romain327/machine-turing/rapport/rapport.pdf

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

# Table des matières

1 Introduction | 2
2 Reprise de l'existant | 5
3 Conception | 6
3.3.4 | Spécications des fonctions et de leurs signaux de communication . . . . 13
4 Synthèse | 32
5 Remerciements | 33
6 Annexes | 34

# Introduction

1.1 Un peu d'histoire...

En 1928, Le mathématicien allemand David Hilbert énonce le "problème de la décision". Il se demande s'il est possible de trouver une méthode eectivement calculable pour décider si une proposition est démontrable. Pour résoudre ce problème, il faut caractériser ce qu'est un procédé eectivement calculable. C'est alors qu'Alan Turing, alors en thèse à Cambridge, conceptualise une machine universelle et prouve grâce à cette dernière que le problème de l'arrêt est indécidable, ce qui permet de donner une réponse négative au problème d'Hilbert pour l'arithmétique. C'est alors qu'Alan Turing introduit les concepts de programme et programmation.
Ce concept de machine universelle, que nous appellerons désormais Machine de Turing Universelle (MTU) n'est pas réalisable puisqu'il s'agit d'un objet mathématique, dont on va détailler le fonctionnement plus tard. Néanmoins, une Machine de Turing à état ni peut-être construite, et la première vit donc le jour à Bletchley Park pendant la Seconde Guerre Mondiale, où Turing lui-même et une équipe de scientique triés sur le volet par le MI6 ¹
construisirent une Machine de Turing pour casser les codes allemands générés par la machine Enigma. [1]

## 1.2 Fonctionnement d'une MTU

Une MTU se compose de quatre éléments essentiels :
− un ruban de taille innie, divisé en cases.
− une tête de lecture/écriture (qu'on appellera simplement tête de lecture, même si elle permet également d'écrire sur le ruban)
− un état interne
− une table de transition.
Une machine de Turing traite des symboles. L'ensemble des symboles est appelé Alphabet. Le ruban permet d'accueillir des symboles qui seront lus et écrits par la tête de lecture.
La tête de lecture permet de lire et écrire un symbole. Elle peut se déplacer vers la gauche ou la droite.

Une machine de Turing fonctionne donc de la manière suivante :
1. La tête de lecture lit le symbole qu'elle pointe sur le ruban.
2. En fonction de son état et du symbole lu, la tête de lecture écrit un symbole à la place de celui qu'elle a lu précédemment.
1. Services de renseignement britanniques

3. Un déplacement est choisi en fonction de l'état de la tête de lecture et du symbole lu.
4. La tête de lecture change d'état.
5. Le ruban se déplace vers la droite ou vers la gauche selon le déplacement choisi précédemment.
6. Puis on recommence depuis le 1.
On peut donc résumer le fonctionnement comme cela : à chaque "cycle", on choisi un symbole à écrire, un nouvel état pour la tête de lecture, et un déplacement, en fonction d'un symbole lu et de l'état actuel. On peut donc dénir une fonction de transition, qui va se charger de déterminer l'état futur d'une MTU en fonction de ton état courant. L'ensemble des fonctions de transition permettant de traiter un "mot" peut être représenté sous la forme d'une table de transitions ou d'un graphe de transitions.
Un mot traité est dit accepté si une Machine de Turing s'arrête en état nal après l'avoir intégralement traité.
Une MTU possède forcément un nombre ni d'états, et elle a au moins deux états obligatoires : qO l'état initial, et F un ensemble d'états d'acceptation.

Une machine de Turing est donc dénie par :

− Q un ensemble ni d'états.

− q0 un état initial tel que q0 ∈ Q.

− F un ensemble d'états d'acceptation tel que F ⊆ Q.

− Γ un ensemble ni de symboles.

− Σ un ensemble ni de symboles d'entrée tel que Σ ⊆ Γ.

− B un symbole de ruban vide tel que B ∈ Γ \ Σ.
− δ une fonction de transition.

Une fonction de transition se formalise donc comme ceci :

δ(q, Z) → (p, Y, D)

avec q l'état de la tête de lecture, Z le symbole pointé, p le nouvel état, Y le nouveau symbole et D le déplacement. [2]

Exemple d'une table de transition pour une Machine de Turing acceptant le langage L = {a

k
b

k
| k > 0} avec q0 comme état initial (représenté par une →), et q4 comme état d'acceptation (représenté par ∗) :


Le but de ce projet va donc être de concevoir une Machine de Turing électronique fonctionnant tel que déni ci-dessus.

# Reprise de l'existant

Le projet Machine de Turing se base sur un système existant dans le commerce. Le but est de concevoir une machine avec des fonctionnalités se rapprochant de ce modèle existant.[3]
Ce projet avait déjà été donné l'an passé, et nous avons eu accès à l'analyse et la maquette produite par le groupe qui s'en était chargé.
Leur maquette fonctionne, elle se compose de 8 boutons poussoirs, d'un micro-contrôleur PIC24FJ64GA002, et de deux matrices de LEDs SparkFun communiquant en SPI.
Nous avons trouvé que leur travail pouvait être amélioré, et nous avons proposé un cahier des charges ambitieux au client. Le travail d'analyse eectué l'an passé correspondait à peu près à la partie 1 de notre cahier des charges, c'est pourquoi nous avons décidé de rajouter deux autres parties, pour nous rapprocher le plus possible du système modèle.

# Conception

## 3.1 Cahier des charges

Le cahier des charges est composé de trois parties. La partie 1 doit être traitée absolument, les parties 2 et 3 seront traitées si le temps nous le permet.

### 3.1.1 Partie 1

Dans un premier temps, le système conçu doit être capable de :
− exécuter un programme prédéni (codé en dur dans le programme microcontrôleur). − avoir un mode pas à pas pour l'exécution du programme.
− avoir un mode continu pour l'exécution du programme.
− gérer l'achage de l'état du ruban.
− gérer l'achage de la position de la tête de lecture.
− gérer l'achage de la table de transition.

### 3.1.2 Partie 2

Dans un second temps, il faut rajouter :
− la possibilité de sélectionner un programme via un menu.
− le stockage des programmes à sélectionner.
− l'initialisation manuelle du ruban et de la position de la tête de lecture.

### 3.1.3 Partie 3

Enn pour obtenir un système complet, il faut implémenter :
− la programmation directement sur la machine d'une table de transition.
− l'enregistrement de la table de transition programmée dans le support de stockage. − un reset de la programmation de la ligne en cours.
− l'achage d'une description du programme.

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

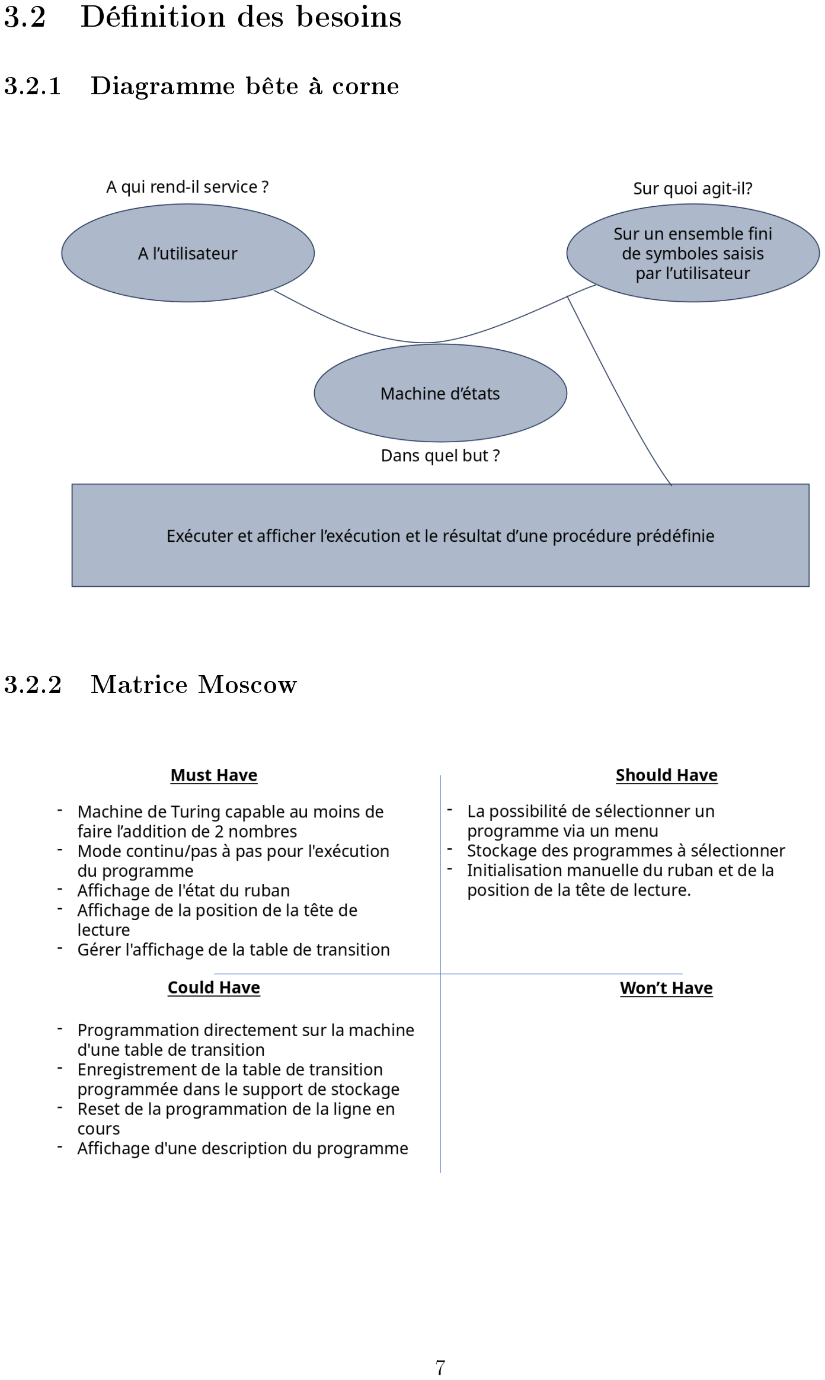
[picture p53: page 8]

## 3.3 Conception Matérielle

Pour concevoir notre système, nous avons décidé de traiter les trois parties en même temps, ce qui nous évite de devoir repasser par une phase de conception et d'adaptation lors de la réalisation des parties 2 et 3.

### 3.3.1 SFN1

Nous avons donc commencé par dessiner un Schéma fonctionnel de premier niveau, pour dénir les diérentes entrées et sorties de notre système :


### 3.3.2 SFnD

On peut désormais rentrer un peu plus dans le détail avec un SF1D :

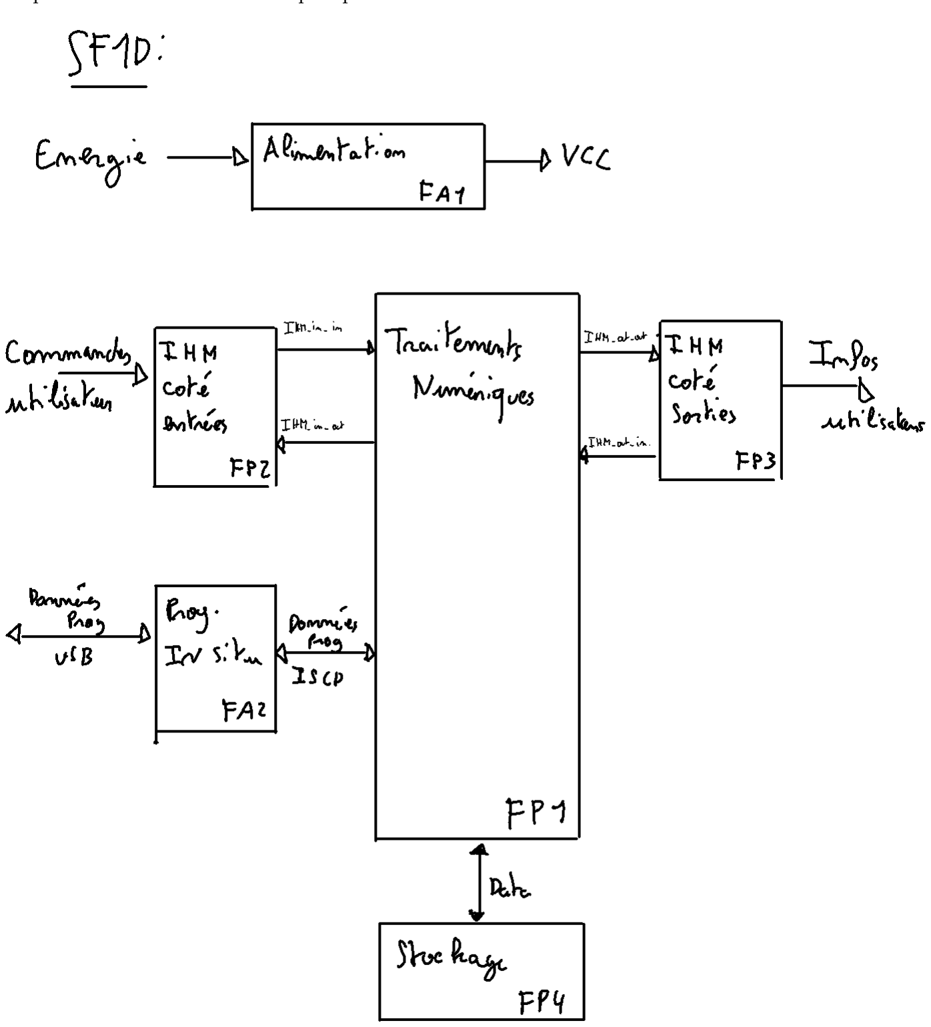
[picture p54: figure]

On voit qu'on a quatre fonctions principales : une qui s'occupe de la gestion des entrées (FP2), une qui gère les sorties (FP3), une fonction de stockage pour stocker les tables de transitions (FP4), et du traitement numérique qui va piloter tout ça (FP1).
On a aussi deux fonctions annexes : la fonction alimentation qui va se charger de fournir le courant nécessaire pour que la machine puisse fonctionner, et la fonction de programmation in-situ qui va faciliter le chargement du code dans la machine et nous éviter d'avoir à sortir le micro-contrôleur (MCU) à chaque fois.

On voit que les fonctions FP2 et FP3 sont encore oues, on va donc les aner en faisant des SF2D pour qu'on se rende compte de leur fonctionnement :

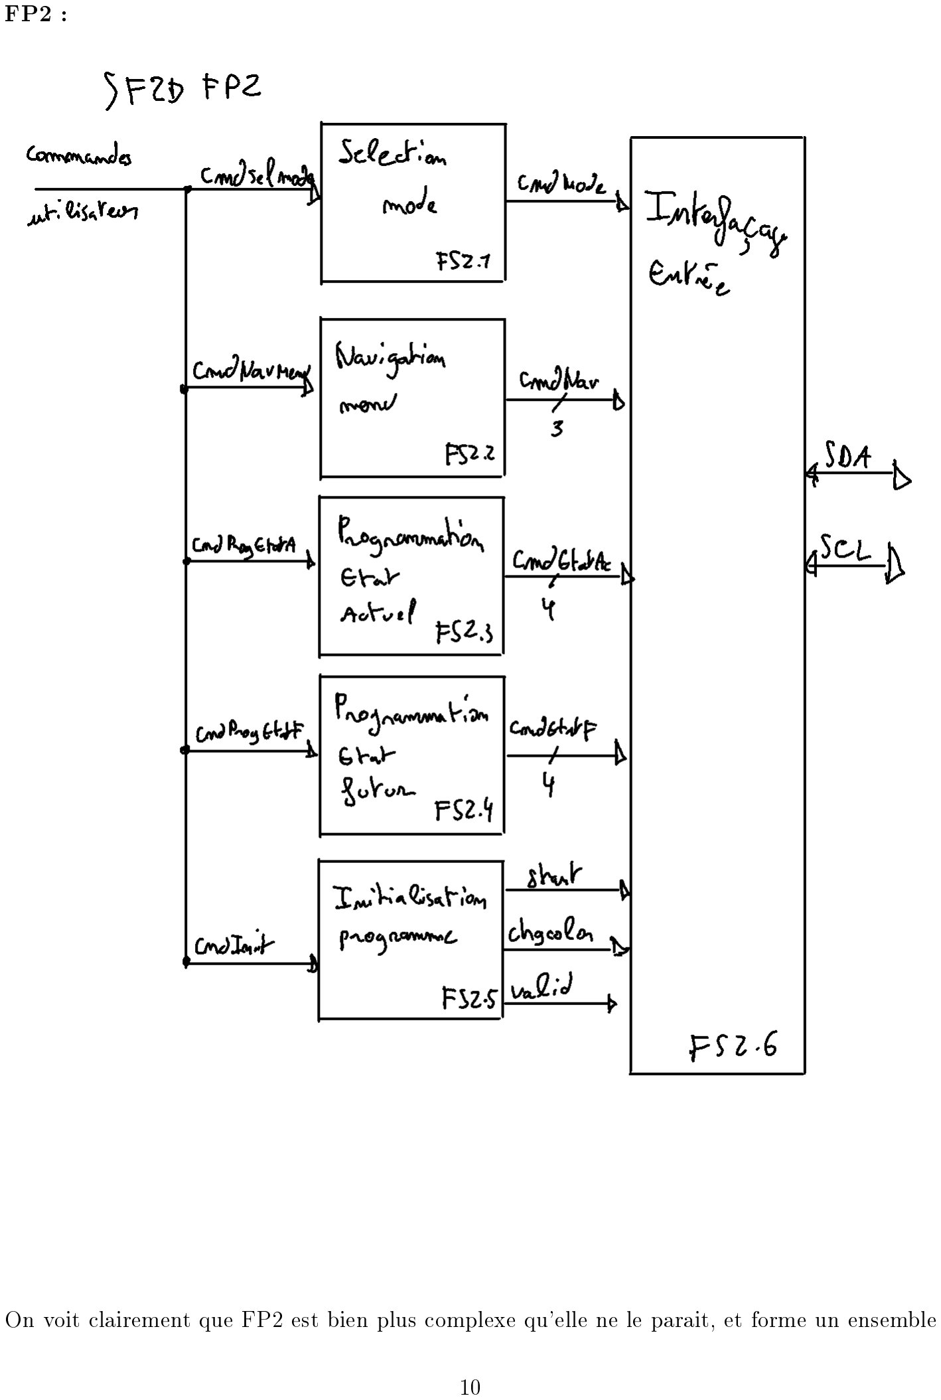
[picture p55: page 11]

FP2 :

On voit clairement que FP2 est bien plus complexe qu'elle ne le parait, et forme un ensemble de fonctions plus spéciques qui vont permettre à l'utilisateur d'interagir physiquement avec la machine, dans le but de la congurer, programmer, etc.


FP3 :

De la même manière que pour FP2, FP3 est en réalité un ensemble de fonctions plus spéciques qui vont chacune avoir un rôle bien précis dans le retour des informations utilisateur. On a donc une grande variété de fonctions d'achage qui vont, de la même manière que pour les sousfonctions de FP2, être spéciées ci-dessous.

### 3.3.3 Choix des technologies

Communication

Bus I²C Le nombre élevé d'entrées-sorties, du aux grand nombre de boutons poussoirs et composants d'achage, nous a orienté sur l'utilisation d'expandeurs. Nous nous sommes orientés vers des expandeurs I²C, car l'utilisation du bus I²C nous permettait de gérer toutes nos entrées / sorties en utilisant uniquement deux broches sur le MCU (SDL et SCL). Nous avons ainsi essayé d'avoir un maximum de composants en I²C.

Bus SPI Nous nous sommes posés la question de l'utilisation du bus SPI pour notre ruban de LEDs. Nous avions aussi besoin de choisir notre type de communication avec la carte SD, et il se trouve que le bus SPI est très utilisé pour ce type de communication.

### 3.3.4 Spécications des fonctions et de leurs signaux de communica- tion

Nous avons donc spécié ci-dessous, pour chaque fonction, son rôle ainsi que ses signaux d'entrée et/ou de sortie. Nous avons également précisé le rôle ainsi que ce qui fait l'essence même de chaque signal (type, etc.).


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

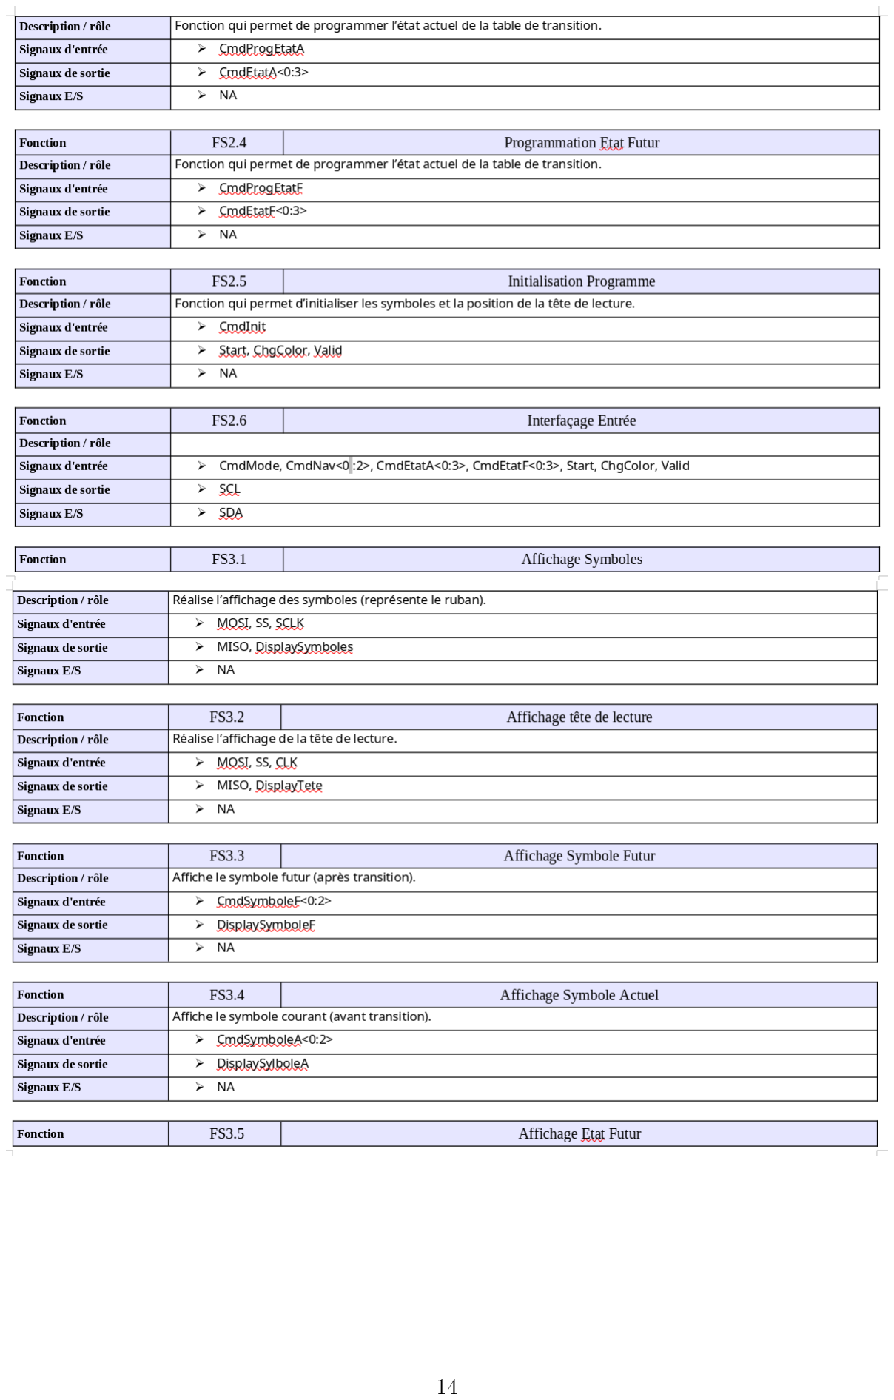
[picture p56: page 15]

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

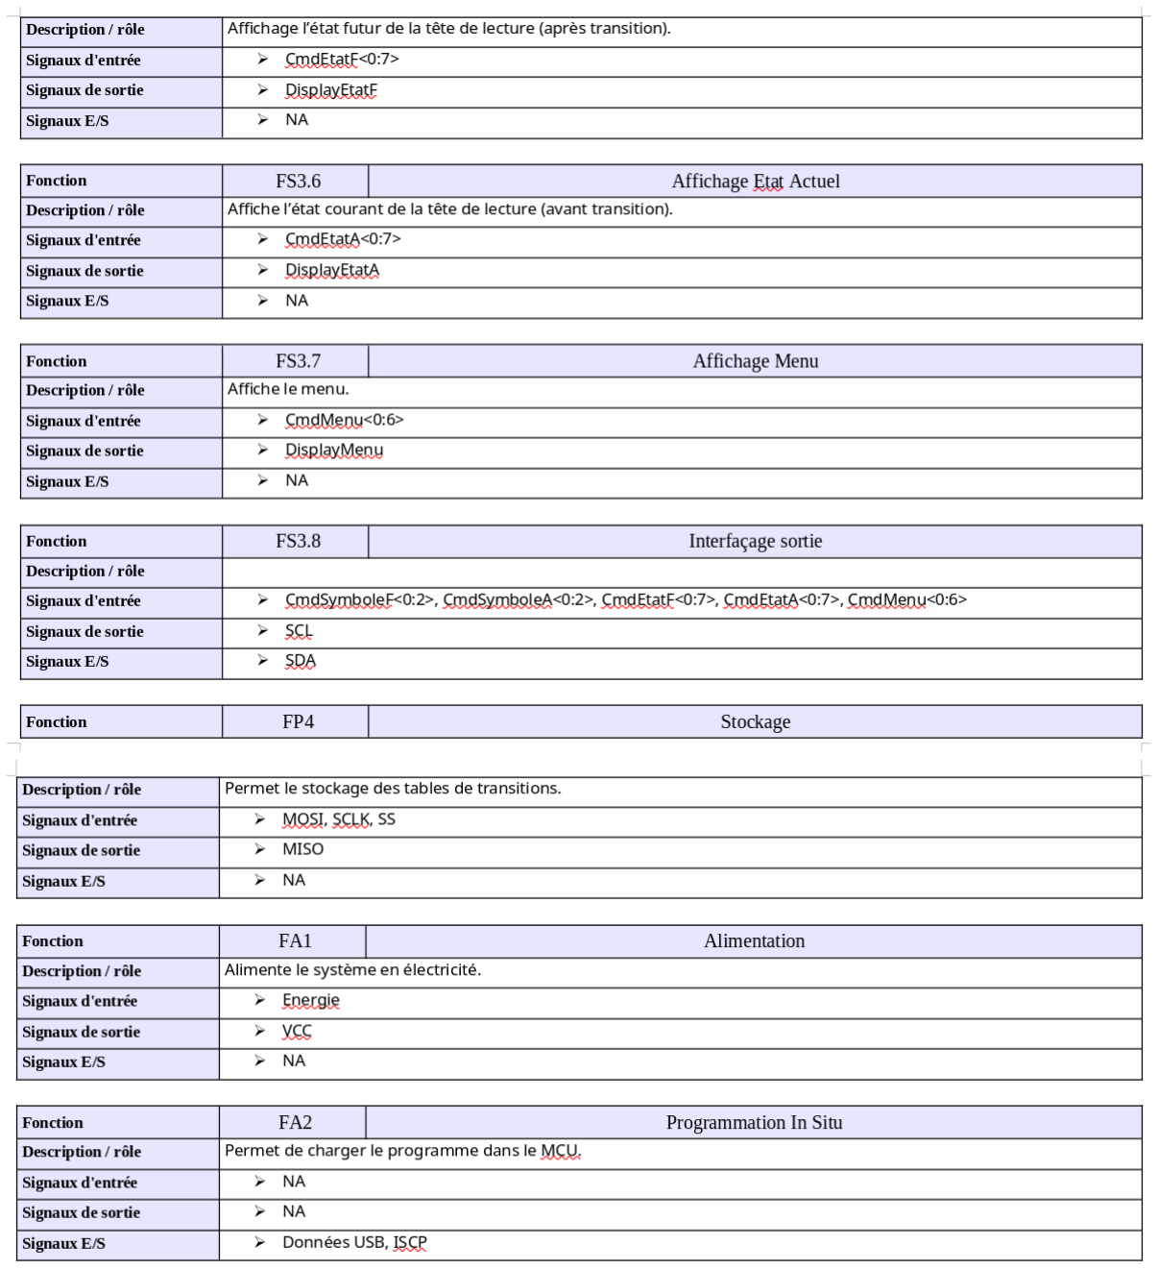
[picture p57: figure]

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

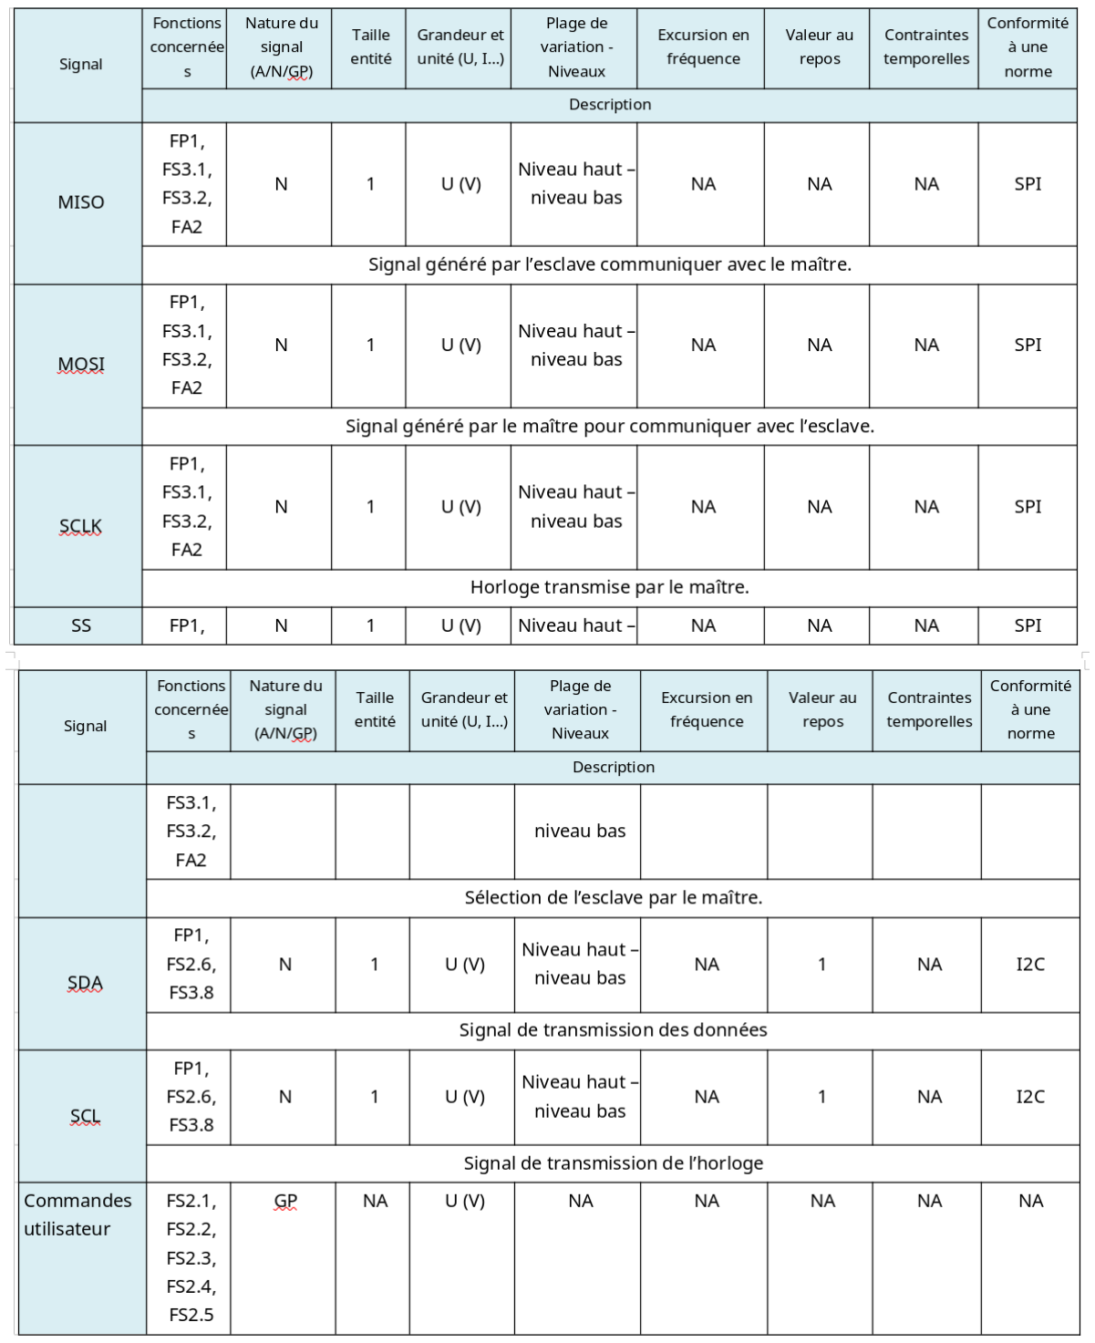
[picture p58: figure]

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

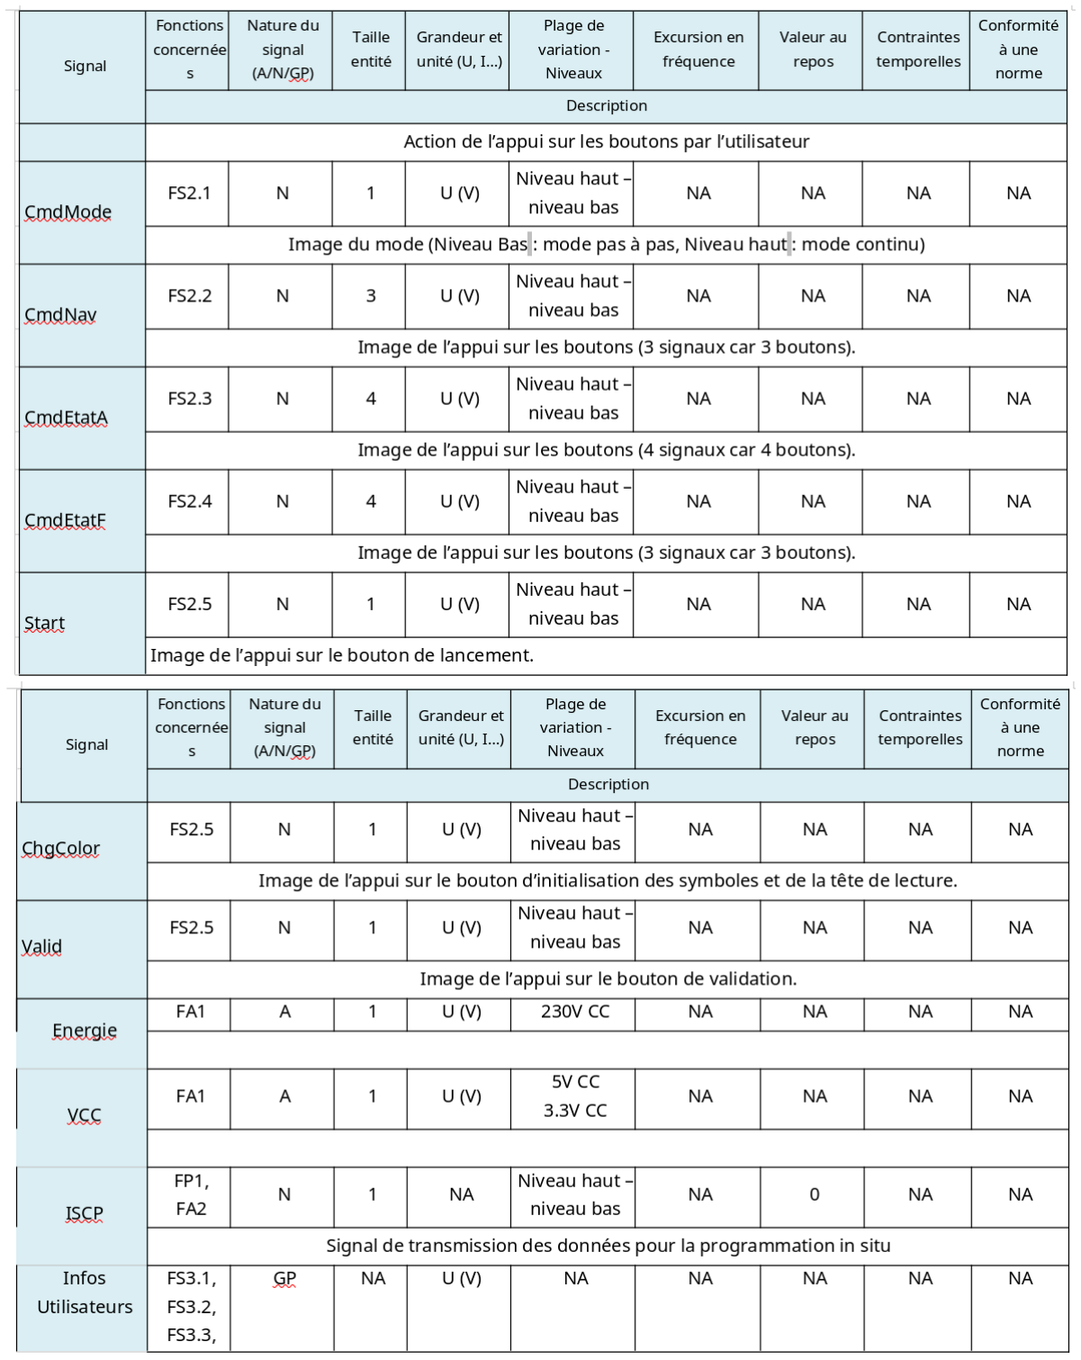
[picture p59: figure]

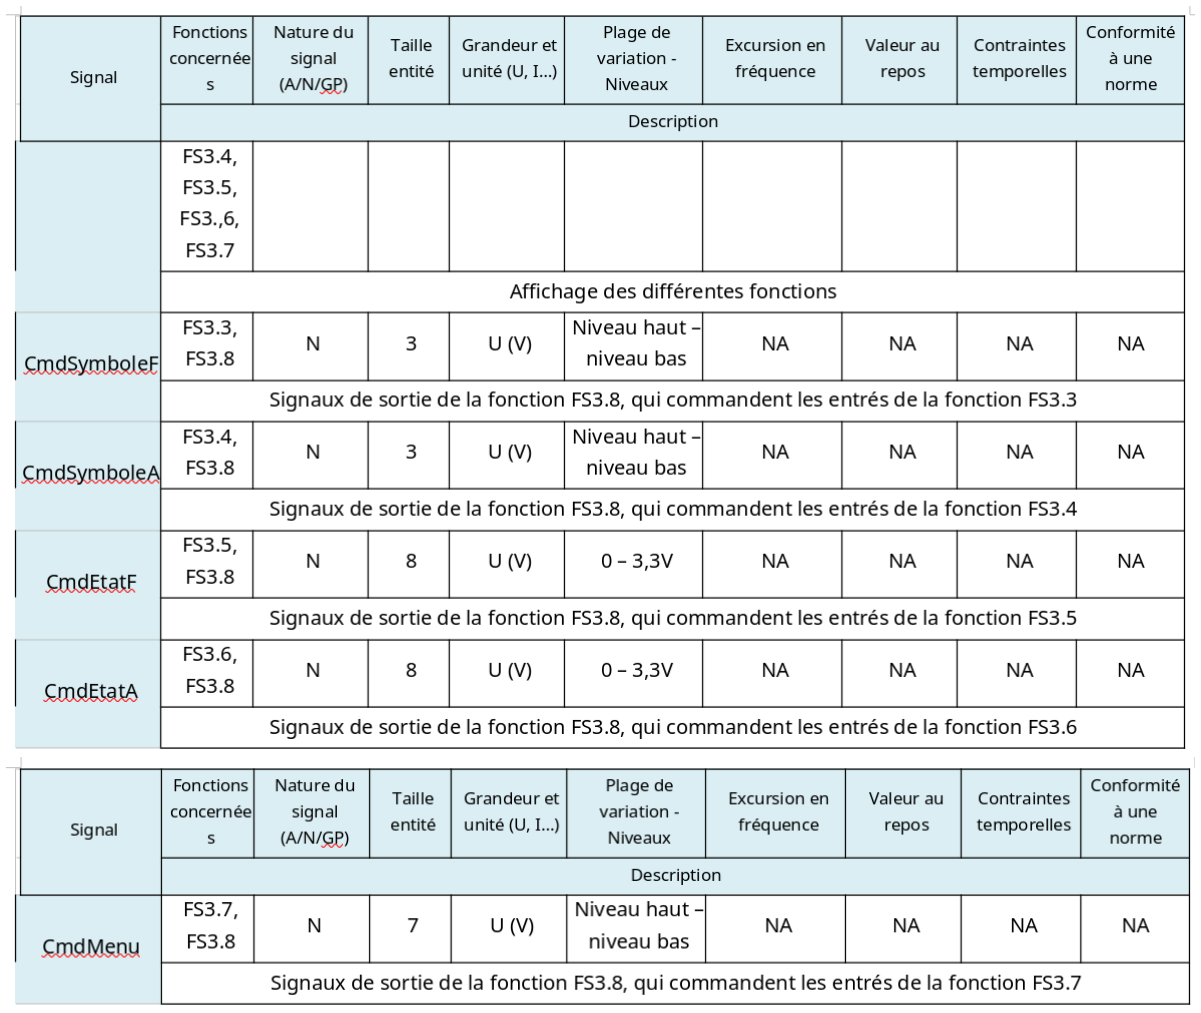
[picture p60: figure]

### 3.3.5 Choix des composants

Composants

Nous avions donc besoin des composants suivants : − 2 rubans de LEDs RGB communicant en SPI − 2 acheurs 7 segments
− 1 écran LCD communicant en I²C
− 2 LEDs RBG
− 2 LEDs pour indiquer le mouvement, et 1 LED d'erreur − 15 boutons poussoirs
− 2 commutateurs à bascule
− 1 lecteur de carte micro-SD communicant en SPI − 3 expandeurs E/S - I²C de 16 I/O

Choix du micro contrôleur

Nous avions déjà un PIC24FJ64GA002 car c'est le micro-contrôleur que le groupe précédent utilisait. Ce micro-contrôleur s'alimente en 3,3V et possède deux modules I²C et deux modules SPI. Comme nous utilisons des expandeurs pour toutes nous E/S, nous pouvons reprendre ce micro-contrôleur pour notre machine de Turing.

Commandes

Initialement, nous avions fait un premier choix de composants qui correspondait à nos spéci-cités. Tous les composants s'alimentent en 3,3 ou 5V. Toute la commande était prévue chez Farnell, mais nous avons dû nous raviser et mettre au point une autre liste à cause du délai de commande trop important.

Commande initiale Farnell
− rubans de LEDs adressables SK9822 (https://fr.aliexpress.com/item/1005006918408592.html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) − acheurs 7 segments HDSM-283B (https://fr.farnell.com/broadcom-limited/hdsm-283b/afficheur-a-led-cms-7mm-bleu-cc/dp/1659312) − LEDs RGB L-59EYC (https://fr.farnell.com/kingbright/l-59eyc/led-5mm-tricolore/dp/1168662)
− expandeurs E/S - I²C MCP23017 (https://fr.farnell.com/microchip/mcp23017-e-sp/16-bit-expander-i-o-i2c-i-f/dp/1332088)
− écran LCD I2C MC21605C6W-BNMLWI-V2 (https://fr.farnell.com/midas/mc21605c6w-bnmlwi-v2/afficheur-alphanumerique-16x2/dp/2748649) − boutons poussoirs ESE20C321 (https://fr.farnell.com/panasonic/ese20c321/commutateur-bouton-pouss-momentane/dp/2079613)
− commutateurs 2AS2T2A1M7RE (https://fr.farnell.com/multicomp/2as2t2a1m7re/switch-toggle-spdt-on-mom/dp/1550118)

Commande réelle (RS et Amazon) − rubans de LEDs adressables SK9822 (https://fr.aliexpress.com/item/1005006918408592.html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)
− expandeurs E/S - I²C MCP23017 (https://fr.farnell.com/microchip/mcp23017-e-sp/16-bit-expander-i-o-i2c-i-f/dp/1332088)
− écran LCD I²C NHD-C0220BiZ-FSW-FBW-3V3M (https://fr.rs-online.com/web/p/afficheurs-monochromes-lcd/2644045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)

− LEDs RGB L-154A4SURKQBDZGW (https://fr.rs-online.com/web/p/leds/1651767?gb=s)

### 3.3.6 Schéma représentatif

Le schéma ci-dessous nous donne une idée de ce à quoi pourrait ressembler notre machine de Turing une fois tous les composants montés :


Nous avons essayé de respecter les connexions minimales recommandées de Microchip, trouvées dans la documentation de notre micro-contrôleur à la page 17 (voir Annexe 4.1). Légende :

− 1 : Interrupteur d'alimentation
− 2 : Ruban de LEDs pour l'achage des symboles
− 3 : Ruban de LEDs pour l'achage de la tête de lecture
− 4 : Commutateur pour choisir entre le mode pas à pas et automatique
− 5 : Bouton de réinitialisation lors de l'initialisation manuelle des rubans de LEDs
− 6 : Ecran LCD pour l'achage du menu
− 7, 8, 9 : Boutons de navigation dans le menu (monter, sélectionner, descendre)
− 10 : Bouton de lancement du programme. Sert également à passer à l'étape suivante en mode pas à pas
− 11 | 20 : Acheurs 7 segments pour l'achage de l'état courant | de l'état suivant
− 12 | 21 : LEDs RGB pour l'achage du symbole courant | du symbole suivant
− 13, 14, 15, 16 | 22, 23, 24, 25 : Boutons de décrémentation, validation, incrémentation,
ré-initialisation de l'état et du symbole courant | de l'état et du symbole futur
− 17 : Bouton de changement du déplacement pour l'état suivant
− 18, 19 : LED représentant le déplacement pour l'état suivant (gauche si LED 18 allumée, droite si LED 19 allumée)
− 26 : Bouton de sélection d'un état d'acceptation
− 27 : Lecteur de carte micro-SD

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

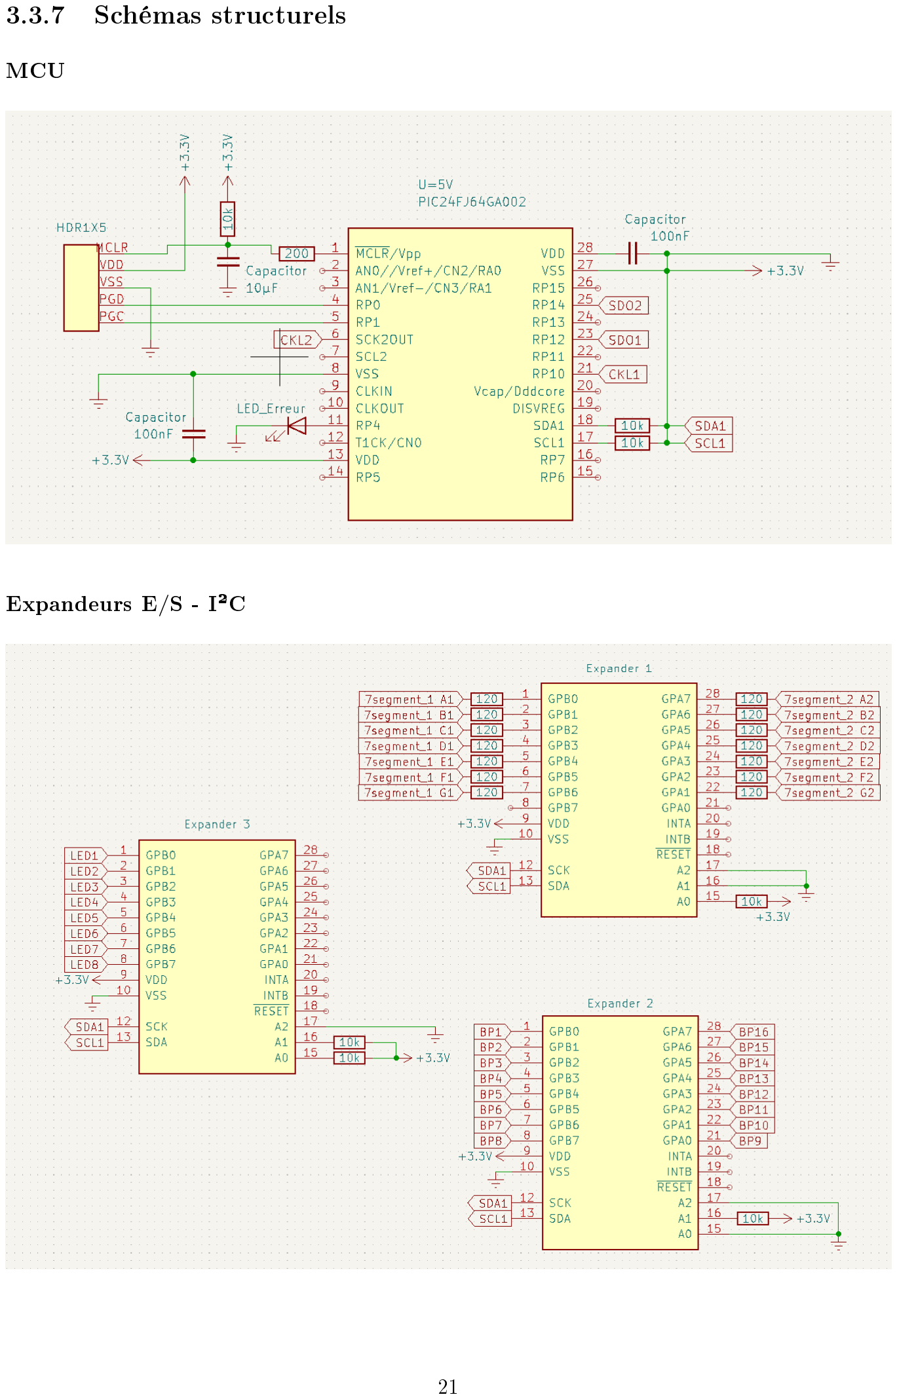
[picture p61: page 22]

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

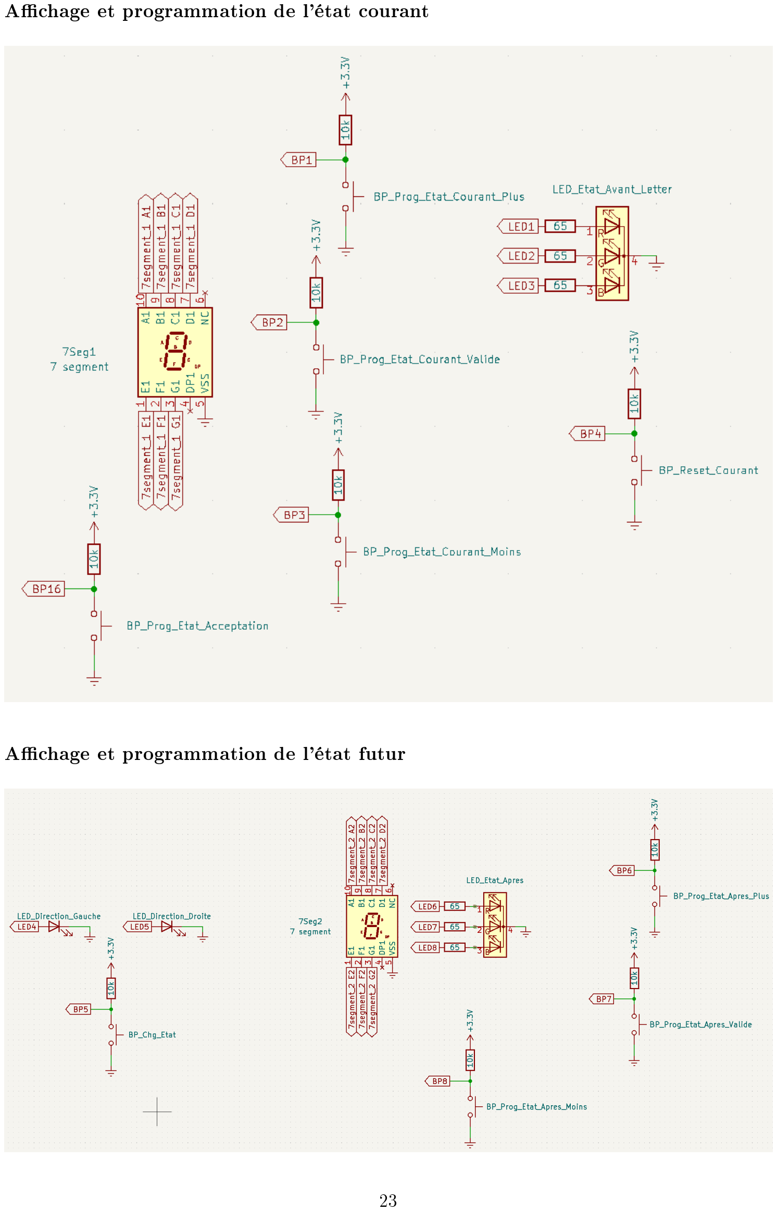
[picture p62: page 24]

### 3.3.8 Tests

Nous avons manqué de temps pour eectuer des tests. Néanmoins nous en avons écrits un, permettant de tester la communication entre le micro-contrôleur, et l'expandeur I²C :


### 3.3.9 Conception Logicielle

Cette section ne traitera que la partie 1 du cahier des charges, les parties 2 et 3 ne pouvant être réalisées par manque de temps.
La table de transition "Addition de deux binaires" que nous avons utilisé pour notre machine de Turing est disponible à l'annexe 4.2

### 3.3.10 Diagramme de Séquences

Les deux diagrammes de séquence ci-dessous montrent respectivement la phase d'initialisation et la phase de déroulement du programme au niveau du micro-contrôleur (on ne prend pas en compte les actions de l'utilisateur).
Ce sont des diagrammes "best-case", c'est à dire qu'on ne prend pas en compte les erreurs qui pourraient survenir, et on déroule le fonctionnement du programme en supposant que tout se passe bien. Cela permet principalement de ne pas faire trop de diagrammes, ni de diagrammes trop longs.

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

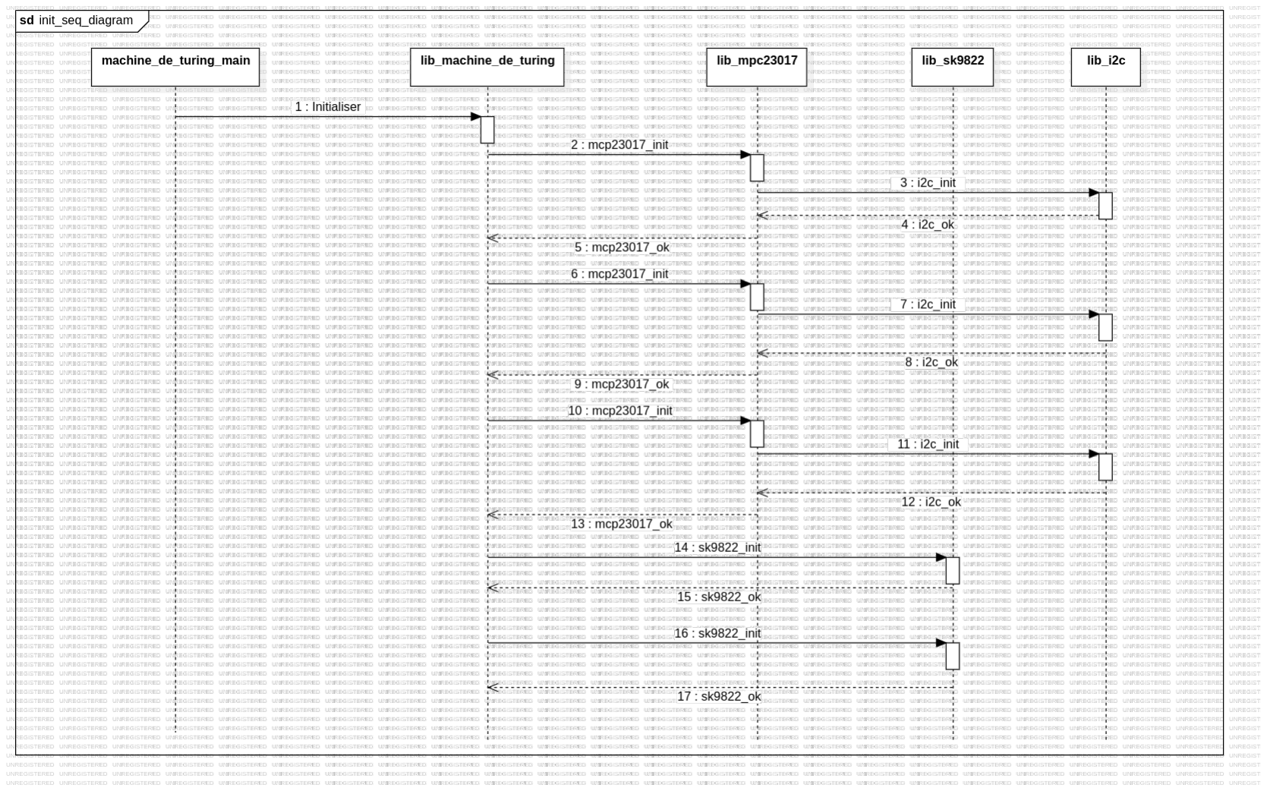
[picture p63: figure]

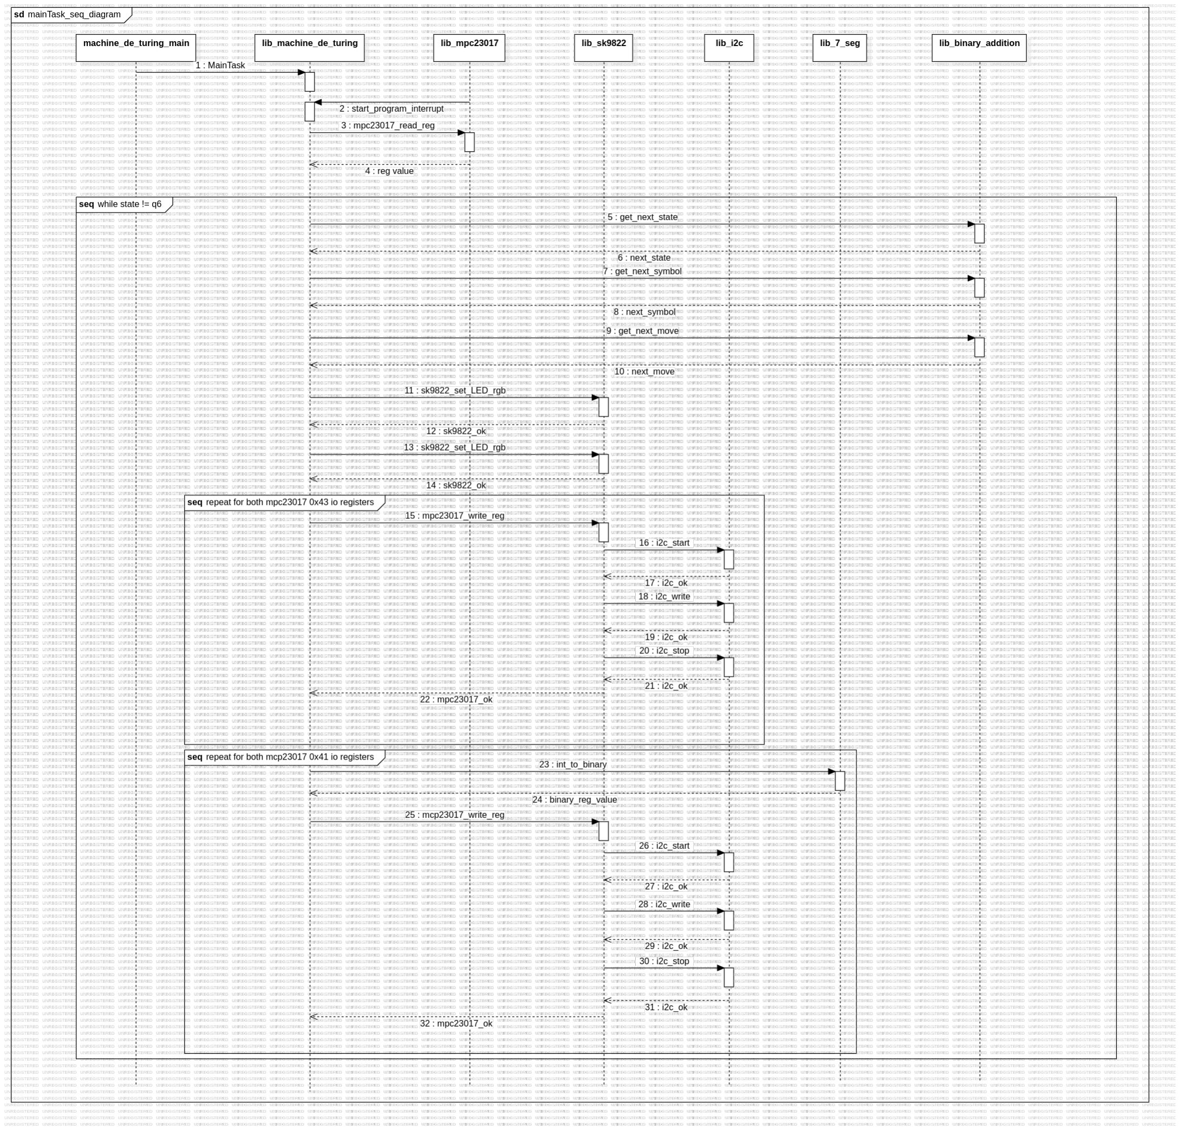
[picture p64: figure]

### 3.3.11 Algorithme

Cet algorithme reprend les deux diagrammes de séquences ci-dessus.

1 | LIB_MACHINE_DE_TURING
2 | VARIABLES
3 | mcp23017_desc_t mpc23017_7_seg
4 | mcp23017_desc_t mcp23017_bp
5 | mcp23017_desc_t mcp23017_general
6 | i2c_desc_t I2CModule

7
8 | ENUMERATIONS
9 | mcp23017_err_t
10 | MCP23017_OK
11 | MCP23017_ERROR

12
13 | mcp23017_i2c_init_type_t
14 | INIT_WITH_I2C1
15 | INIT_WITH_I2C2
16 | INIT_ALREADY_DONE

18 | working_mode_t
19 | MANUAL_MODE
20 | AUTOMATIC_MODE

21
22 | STRUCTURES
23 | mcp23017_desc_t
24 | i2c_desc_t | * pi2c
25 | uint8_t | i2c_Address

26
27 | mcp23017_config_t
28 | i2c_desc_t | * pi2c ;
29 | mcp23017_i2c_init_type_t | initType ;
30 | uint8_t i2c_Address ;

31

32
33 | machine_de_turing_desc_t
34 | uint8_t state
35 | uint8_t symbol
36 | uint8_t next_state
37 | uint8_t next_symbol
38 | uint8_t next_move

39
40 | CONSTANTES
41 | MCP23017_7_SEG_ADDRESS | 0100001
42 | MCP23017_BP_ADDRESS | 0100010
43 | MCP23017_GENERAL_ADDRESS | 0100011

44
45 | MCP23017_IOCONA_ADDRESS | 0 x0A
46 | MCP23017_IOA_ADDRESS | 0 x12
47 | MCP23017_IOB_ADDRESS | 0 x13

48
49 | DEBUT
50 | PROCEDURE Initialiser ()
51 | VARIABLES
52 | mcp23017_err_t | Res ;
53 | mcp23017_config_t | mcpCfg ;
54 | DEBUT
55 | Configuration du port B en sortie

56
57 | // MPC23017 7 segs
58 | mcpCfg . pi2c = & I2CModule ;
59 | Initialisation avec I2C_1
60 | Adresse = MCP23017_7_SEG_ADRESS ;

61
62 | Res = mcp23017_init ( @mpc23017_7_seg , @mcpCfg )
63 | SI Res != MCP23017_OK ALORS
64 | error_handler ()
65 | FIN SI

66
67 | // MPC23017 BP
68 | mcpCfg . pi2c = & I2CModule ;
69 | Initialisation avec I2C_1
70 | Adresse = MCP23017_BP_ADDRESS ;

71
72 | Res = mcp23017_init ( @mpc23017_bp , @mcpCfg )
73 | SI Res != MCP23017_OK ALORS
74 | error_handler ()
75 | FIN SI

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

43 | if( mcp23017_write_reg (& mcp23017_7_seg , REG_IOCONA , 0 x00 ) ==
| MCP23017_ERROR ) {
44 | error_handler () ;
45 | }

46
47 | // MCP23017 BP
48 | mcpCfg . i2c_Address = MCP23017_BP ;
49 | Res = mcp23017_init (& mcp23017_bp ,& mcpCfg ) ;
50 | if ( Res != MCP23017_OK ) error_handler () ;
51 | if( mcp23017_write_reg (& mcp23017_bp , REG_IOCONA , 0 x00 ) == MCP23017_ERROR )
| {
52 | error_handler () ;
53 | }

54
55 | // MCP23017 GENERAL
56 | mcpCfg . i2c_Address = MCP23017_GENERAL ;
57 | Res = mcp23017_init (& mcp23017_general ,& mcpCfg ) ;
58 | if ( Res != MCP23017_OK ) error_handler () ;
59 | if( mcp23017_write_reg (& mcp23017_general , REG_IOCONA , 0 x00 ) ==
| MCP23017_ERROR ) {
60 | error_handler () ;
61 | }

62
63 | red . brightness = 0 xFF ;
64 | red . blue = 0;
65 | red . green = 0;
66 | red . red = 0 xFF ;

67
68 | green . brightness = 0 xFF ;
69 | green . blue = 0;
70 | green . green = 0 xFF ;
71 | green . red = 0;

72
73 | lblue . brightness = 0 xFF ;
74 | lblue . blue = 0 xE6 ;
75 | lblue . green = 0 xD8 ;
76 | lblue . red = 0 xAD ;

77
78 | for( uint8_t i = 0; i <3; i ++) {
79 | sk9822_symbol . led_strip_buff [ i ] = lblue ;
80 | }

81
82 | for( uint8_t i = 14; i < N_LED ; i ++) {
83 | sk9822_symbol . led_strip_buff [ i ] = lblue ;
84 | }

85
86 | sk9822_symbol . led_strip_buff [4] = red ;
87 | sk9822_symbol . led_strip_buff [6] = red ;
88 | sk9822_symbol . led_strip_buff [8] = red ;
89 | sk9822_symbol . led_strip_buff [12] = red ;
90 | sk9822_symbol . led_strip_buff [13] = red ;
91 | sk9822_symbol . led_strip_buff [5] = green ;
92 | sk9822_symbol . led_strip_buff [7] = green ;
93 | sk9822_symbol . led_strip_buff [10] = green ;
94 | sk9822_symbol . led_strip_buff [11] = green ;

95
96 | for( uint8_t i = 0; i < N_LED ; i ++) {
97 | sk9822_rw_head . led_strip_buff [ i ] = lblue ;
98 | }

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

# Synthèse

Nous sommes conscient d'avoir vu grand, trop grand. Aujourd'hui, nous pensons avoir une partie d'analyse plutôt solide, nous avons également du code, et nous pensons qu'avec du temps en plus, nous aurions pu arriver à une maquette, au moins de la partie 1. Nous avons manqué de chance vis-à-vis des composants, notamment du ruban de LEDs puisque celui qu'on a reçu ne marche pas.
Nous sommes ers du travail réalisé, l'analyse est là, les composants sont là, le code est partiellement là, et nous avons pu véritablement mettre en pratique tout ce que nous avons appris en AMIIC et Programmation MCU lors de cette année.

Ce rapport ne contient pas tous les documents produits, le reste des est disponible dans le dépôt Teams, ou bien sur github, au lien suivant : https://github.com/romain327/machine-turing. On y trouve notamment les datasheets des composants utilisés, le projet MPLABX contenant les diérentes librairies, les schémas structurels, etc.

# Remerciements

Nous remercions Mr. Bocquillon pour nous avoir encadré tout au long de ce projet.
Nous remercions Mr. Rolland pour ses avis et conseils nous ayant permis d'aner notre analyse. Nous remercions nos camarades de classe : Lucien, François et Kevin pour avoir répondu à nos questions et nous avoir conseillé.

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

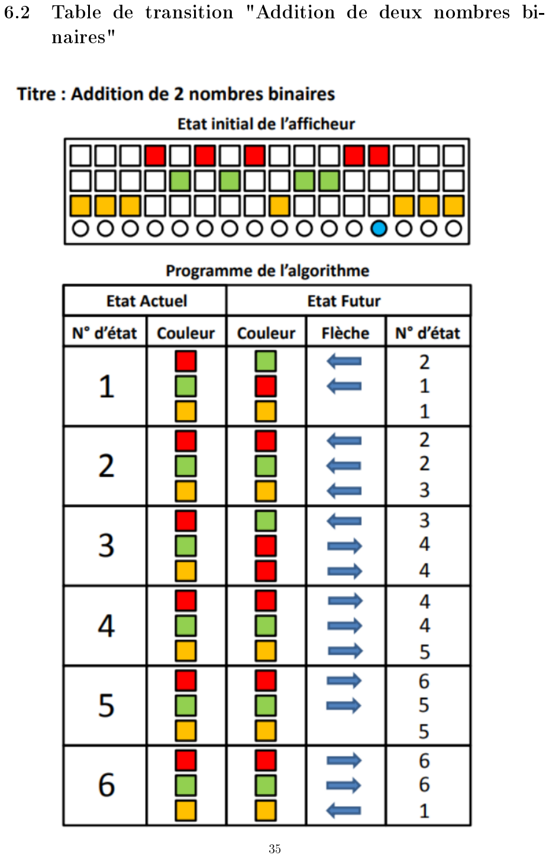
[picture p65: page 36]

# Bibliographie

[1] https://fr.wikipedia.org/wiki/Machine_de_Turing_universelle.
[2] https://fr.wikipedia.org/wiki/Machine_de_Turing.
[3] https://machine-de-turing.fr/.
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
