romain327/machine-turing/presentation/CFAI.png

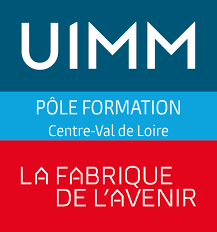
presentation/CFAI.png
