romain327/machine-turing/presentation/Matos/PIC24FJ64GA002-M3X-Regular-removebg-preview.png

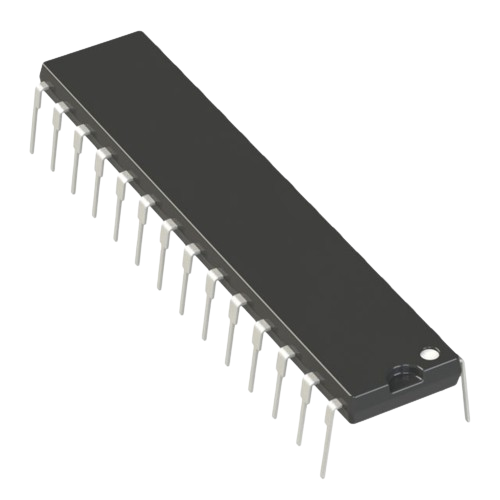
presentation/Matos/PIC24FJ64GA002-M3X-Regular-removebg-preview.png
