romain327/machine-turing/presentation/SFN1-removebg-preview.png

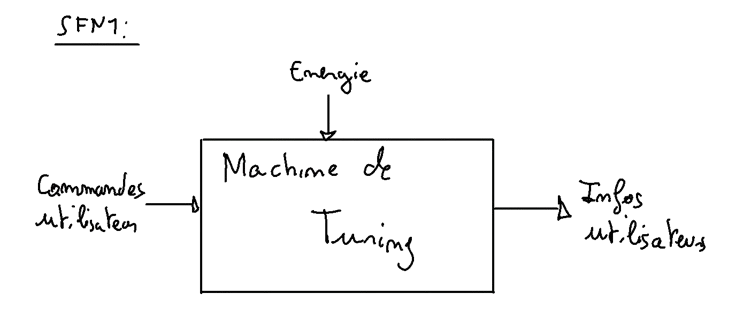
presentation/SFN1-removebg-preview.png
