romain327/machine-turing/rapport/img/Capture d’écran du 2024-06-17 14-50-13.png

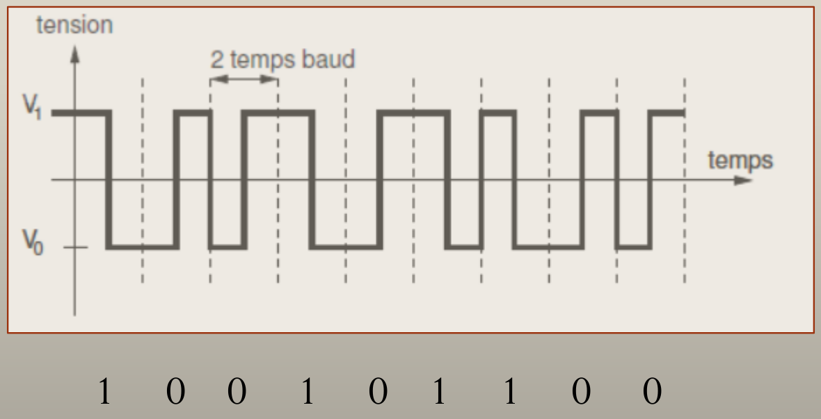
rapport/img/Capture d’écran du 2024-06-17 14-50-13.png
