romain327/machine-turing/Schema/Image/Screenshot_20240613_100124.png

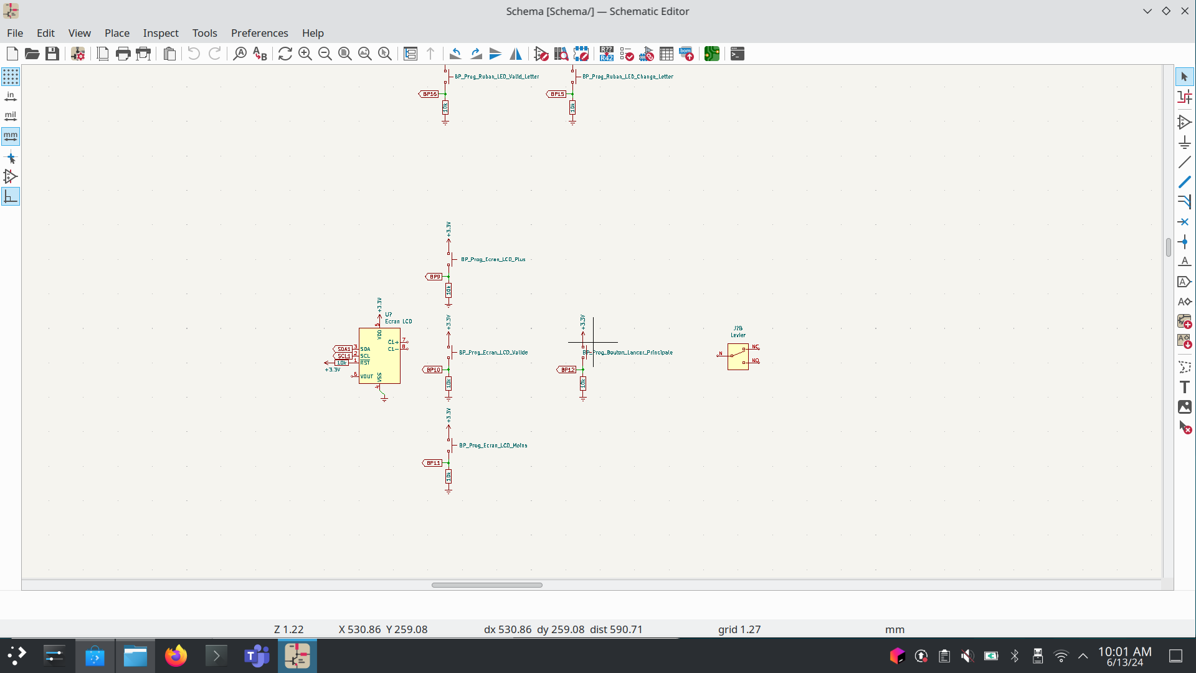
Schema/Image/Screenshot_20240613_100124.png
