romain327/machine-turing/Schema/Image/Screenshot_20240613_100154.png

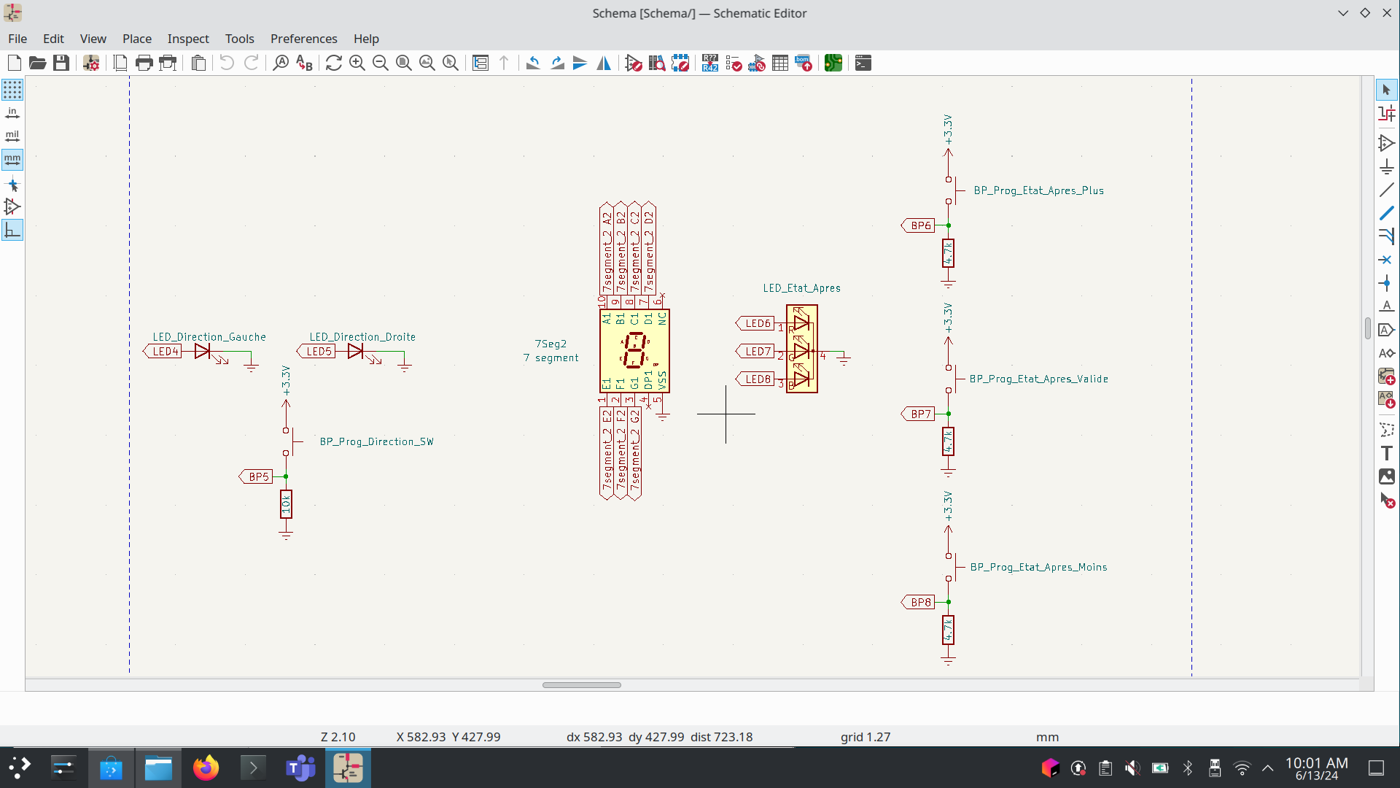
Schema/Image/Screenshot_20240613_100154.png
