romain327/machine-turing/Schema/Image/Screenshot_20240613_100207.png

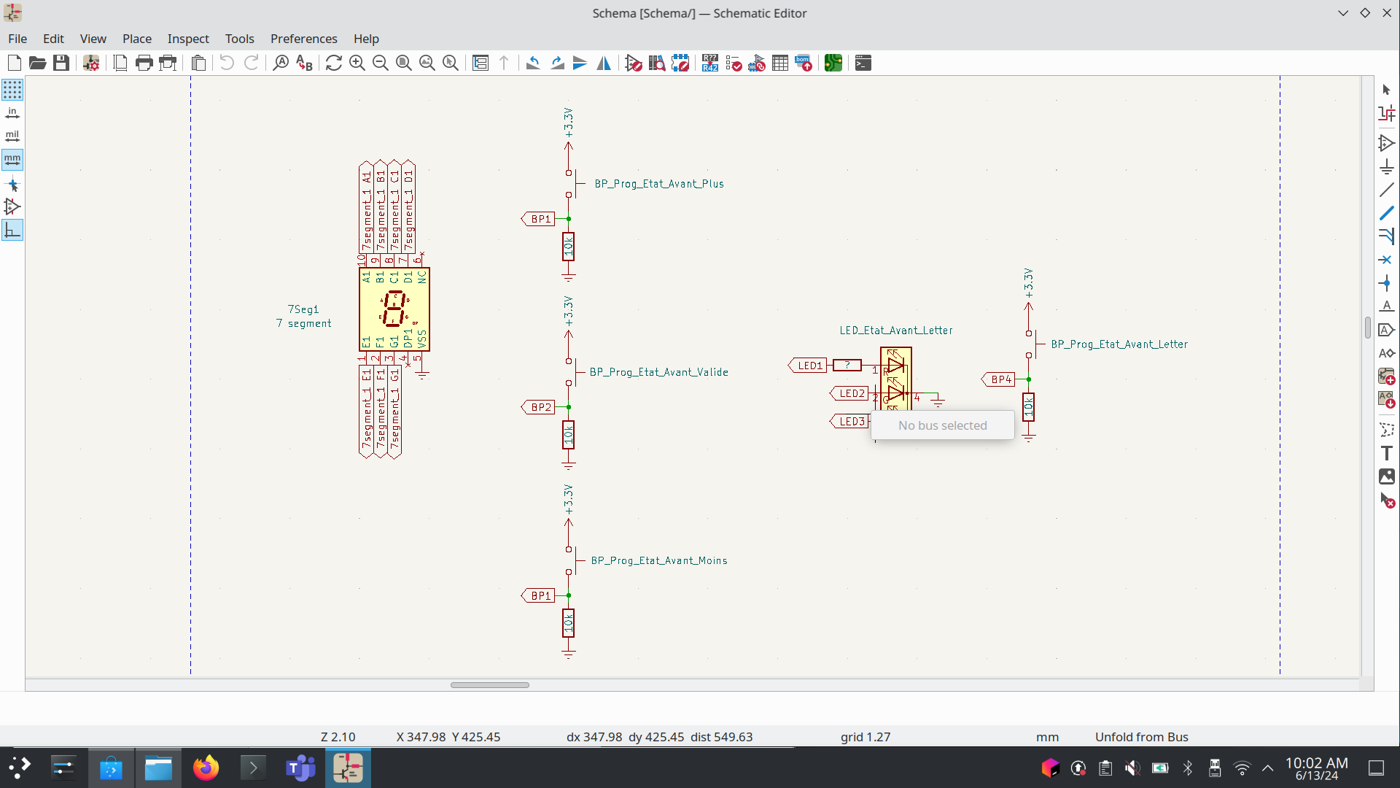
Schema/Image/Screenshot_20240613_100207.png
