romain327/machine-turing/Bon_de_Commande_TVA_20_Machine_Turing.xls

Sheet: Bon à remplir
Fournisseur | Nom | Mouser
 | Adresse
Etudiants | Promotion | ISIE 2023-2026 |  | Encadrant | Nom
 | Noms | BROUARD Romain | ALLEGRE--COMMINGES Clément |  | BOCQUILLON Ronan
Projet | Type | Projet elec
 | Identifiant (titre ou Id) | Machine de Turing
N° nom. | Références | Devis | Désignation produits, prestations |  | N°inventaire | Montant unitaire H.T. | Quantité | Montant H.T. | Montant T.V.A. | Montant T.T.C.
 | MC21605C6W-BNMLWI-V2 |  | Ecran LCD I2C |  |  | 14.80 € | 1 | 14.80 € | 2.96 € | 17.76 €
 | HDSP-7513 |  | Afficheur 7 segments |  |  | 3.45 € | 2 | 6.90 € | 1.38 € | 8.28 €
 | L-59EYC |  | LED RGB |  |  | 0.42 € | 2 | 0.84 € | 0.17 € | 1.01 €
 | MCP23017 |  | Expandeur IO/I2C |  |  | 2.08 € | 1 | 2.08 € | 0.42 € | 2.50 €
 | SK9822 |  | Ruban de leds RGB SPI |  |  | 19.98 € | 1 | 19.98 € | 4.00 € | 23.98 €
 | TLHK5100 |  | LEDS rouges |  |  | 0.47 € | 2 | 0.94 € | 0.19 € | 1.13 €
 | 2AS2T2A1M7RE |  | Interrupteur à bascule |  |  | 2.42 € | 2 | 4.84 € | 0.97 € | 5.81 €
 | ESE20C321 |  | Boutons poussoirs NO |  |  | 1.14 € | 14 | 15.96 € | 3.19 € | 19.15 €
 | BS17O |  | N-mos |  |  | 0.45 € | 2 | 0.90 € | 0.18 € | 1.08 €
 | MRS25000C8450FCT00 |  | Résistances 845 Ohms |  |  | 0.15 € | 7 | 1.05 € | 0.21 € | 1.26 €
 |  |  |  |  |  |  |  | 68.29 € | 13.66 € | 81.95 €
Date | 2024-06-13

Sheet: Fournisseurs
RS
Farnell
Digikey
Mouser
Gotronic
Lextronic
Conrad.pro
LDLC.Pro
Flash RC
Leroy Merlin
