romain327/machine-turing/Tests/FicheTest.xlsx

Sheet: Fiche Test vierge
Système ou Objet Technique | Machine de Turing
Référence du Test
Objectifs du test | Confirmer fonctionnement du MCP23017
Préparation du test
Matériel de mesure à mettre en œuvre | Matériel | Caractéristiques principales
 | Alimentation | 3,3V
 | Oscilloscope
 | Multimètre | Voltmètre
 | GBF
 | Autre(s)
Autres matériels à mettre en œuvre | PIC24FJ64GA002, MCP23017, câbles de branchements
Outillage spécifique
Besoins logiciels
Schémas
Description du test |  |  | Déroulement du test
Etat initial | PIC24 chargé, Platine Breadboard Cablée: MCP23017 branché au PIC24 : pin 12 sur pin 17, pin 13 sur pin 18, pin 10 à la masse pin 9 sur 3,3V |  | Positionnement à l'état initial
Opérations à effectuer | Résultat(s) attendus | Remarques / Précisions | Résultat(s) obtenus | Opération Validée | Remarques / précisions
Mesurer une tension sur la broche 1 du MCP23017 | 3,3V sur le multimètre | Led d'alim allumée |  | Non Validé
 |  |  |  | Non Validé
 |  |  |  | Non Validé
 |  |  |  | Non Validé
 |  |  |  | Non Validé
 |  |  |  | Non Validé
 |  |  |  | Non Validé
 |  |  |  | Non Validé
 |  |  |  | Non Validé
 |  |  |  | Non Validé

Sheet: Sources Data
Validé
Non Validé
