romain327/machine-turing/machine_de_turing/machine_de_turing_main.h

/**
 * @file    lib_i2c_pic24_ll.h 
 * @author 	Alexis ROLLAND
 * @date	2022/02
 * @brief 	Low level library for I2C / PIC24 (PIC24FJ128GA010 fully tested) - Header file
 *          V2 - 05/2024 
 */

#ifndef	__MACHINE_DE_TURING_MAIN_H__
#define	__MACHINE_DE_TURING_MAIN_H__

#include <xc.h>
#include "lib_machine_de_turing.h"


#endif //__MACHINE_DE_TURING_MAIN_H__
