romain327/machine-turing/machine_de_turing/lib_sept_seg.h

#ifndef XC_HEADER_TEMPLATE_H
#define	XC_HEADER_TEMPLATE_H

#include <xc.h> // include processor files - each processor file is guarded.  

uint8_t int_to_bin(uint8_t sept_seg_int);
#endif	/* XC_HEADER_TEMPLATE_H */
