romain327/machine-turing/(commit log)

2024-05-21 push matériel, bon de commande et datasheets
    [Bon_de_Commande_TVA_20_Machine_Turing.xls]
2024-06-04 new datasheet
    [Schema.kicad_pcb, Schema.kicad_sch]
2024-06-11 schema electrique
    [Schema.kicad_sch]
2024-06-11 les schemas sont normalement fini
2024-06-13 schema finiiii
    [Schema.kicad_sch]
2024-06-13 powerpoint presque fini je crois
2024-06-13 powerpoint fini je crois
2024-06-21 nvv eruebvue
    [Schema.kicad_sch]
2024-06-21 correction des fautes, reformulation vite fait synthese
